AlexJudge/Autowatering/(commit log)

2021-04-01 Create TimerStand.ino
    скетч для ардуино, который сохраняет время в миллисекундах возникновения сигнала
2021-06-09 Update TimerStand.ino
    set default mode
2021-06-09 Create results.txt
    add timer stand result as example
